watsonboyett/OttoRemix/firmware/OttoDIY_remix/src/README.md

# Libraries
This repository have all the main [Otto DIY robot](https://www.ottodiy.com/) libraries for Arduino compatible boards

## Installation:

1. [Download the .zip Otto libraries here](https://github.com/OttoDIY/OttoDIYLib/archive/master.zip)
2. Open Arduino IDE and navigate to Sketch > Include Library > Add .ZIP Library. At the top of the drop down list, select the option to ¨Add .ZIP Library¨.
3. You will be prompted to select the library. Navigate to the .zip file's location, that you just downloaded and open it.
4. In the main window you will see in the bottom back area a message that it has been installed. 
5. To verify they are properly installed, go to Sketch > Include Library menu. You should now see the library at the bottom of the drop-down menu. That means is ready to use Otto example codes! you can find them in File > Examples > OttoDIYLib
[for more details or other way to install libraries visit this link](https://www.arduino.cc/en/Guide/Libraries) 
 
## Compatibility:

We are making the libraries more modular and simple than ever, so that you can expand your robot functionallities as you go or you can change components based on your needs or the type of robot you want to make.
You can use both AVR boards like Arduino Nano or Arduino UNO and also ESP8266 or ESP32 boards by changing the definition of the pins.

All our bipedal robots are compatible with this libraries.

* Otto.h and Otto.cpp contains all the main functions
* Otto_gestures contains all the gestures functions
* Otto_mouths contains all the mouth functions
* Otto_sounds contains all the sound functions
* Otto_matrix contains all the matrix functions
* US contains the functions of the ultrasonic sesnor
* SerialCommand is for Bluetooth communication vis Software serial
* Oscillator is the main algorithm for the servos ¨smooth¨ movement
 
## Wiring:
These are the default connections fir AVR Arduino boards, but some Otto remixes do not use all pins or interchange them according to their needs, you can do that too, play with the pins and add new sensors, more motors, displays, LEDs and so on.

Servos| Pin
------------- | -------------
Left Leg or Left Wheel |  2 
Right  Leg or Right Wheel |  3
Left Foot | 4 
Right Foot |  5 
Left arm for Humanoid  |  6 
Right arm for Humanoid |  7 

Ultrasonic | Pin
------------- | -------------
Trigger | 8 
Echo | 9  

Bluetooth | Pin
------------- | -------------
STATE |  10  not required
TX | 11
RX | 12  
ENABLE |  not required

Buzzer | Pin
------------- | -------------
Positive | 13 
 
Touch sensor or Button | Pin
------------- | -------------
OUT | A0 

LED MATRIX 8x8 for the Mouth (MAX7219) | Pin
------------- | -------------
CLK Clock | A1 
CS Chip Select | A2  
DIN Data In | A3 

LED MATRIX 16x8 for the Eyes (i2C*)| Pin
------------- | -------------
SDA Synchronous Data | A4   
SCL Synchronous Clock | A5   

*More i2C devices like OLED or Gyro can be added in parallel by using different address

Sound sesnor | Pin
------------- | -------------
OUT | A6 

 ## How to Contribute:
Contributing to this software is warmly welcomed. There are 3 ways you can contribute to this project:
1. Test and if find a problem then post an issue.
2. Helps us solve the issues or other bugs.
3. Improve and optimize the curren libraries.
You can do this [basically by forking](https://help.github.com/en/articles/fork-a-repo), committing modifications and then [pulling requests](https://help.github.com/en/articles/about-pull-requests). 

Please add a change log and your contact into file header.

Big thanks to all our contributors 
- @JavierIH
- @Obijuan
- @jarsoftelectrical
- @stembotvn
- @sfranzyshen
- @tehniq3
- @logix5
- @DiegoSSJ
- @loreman
- @justinotherguy
- @bhm93
- @wendtbw
- @agomezgar
- @BodoMinea
- @chico
- @PinkDev1
- @MXZZ
- @Pawka
- @per1234
- @FedericoBusero
- @hulkco
- @mishafarms
- @nisha-appanah
- @pabloevaristo
- @ProgrammerBruce
- @Nca78 

Welcome to the [Otto DIY community](http://builders.ottodiy.com/)
