watsonboyett/OttoRemix/hardware/otto.brd

## EAGLE design hardware/otto.brd (2022-01-03)

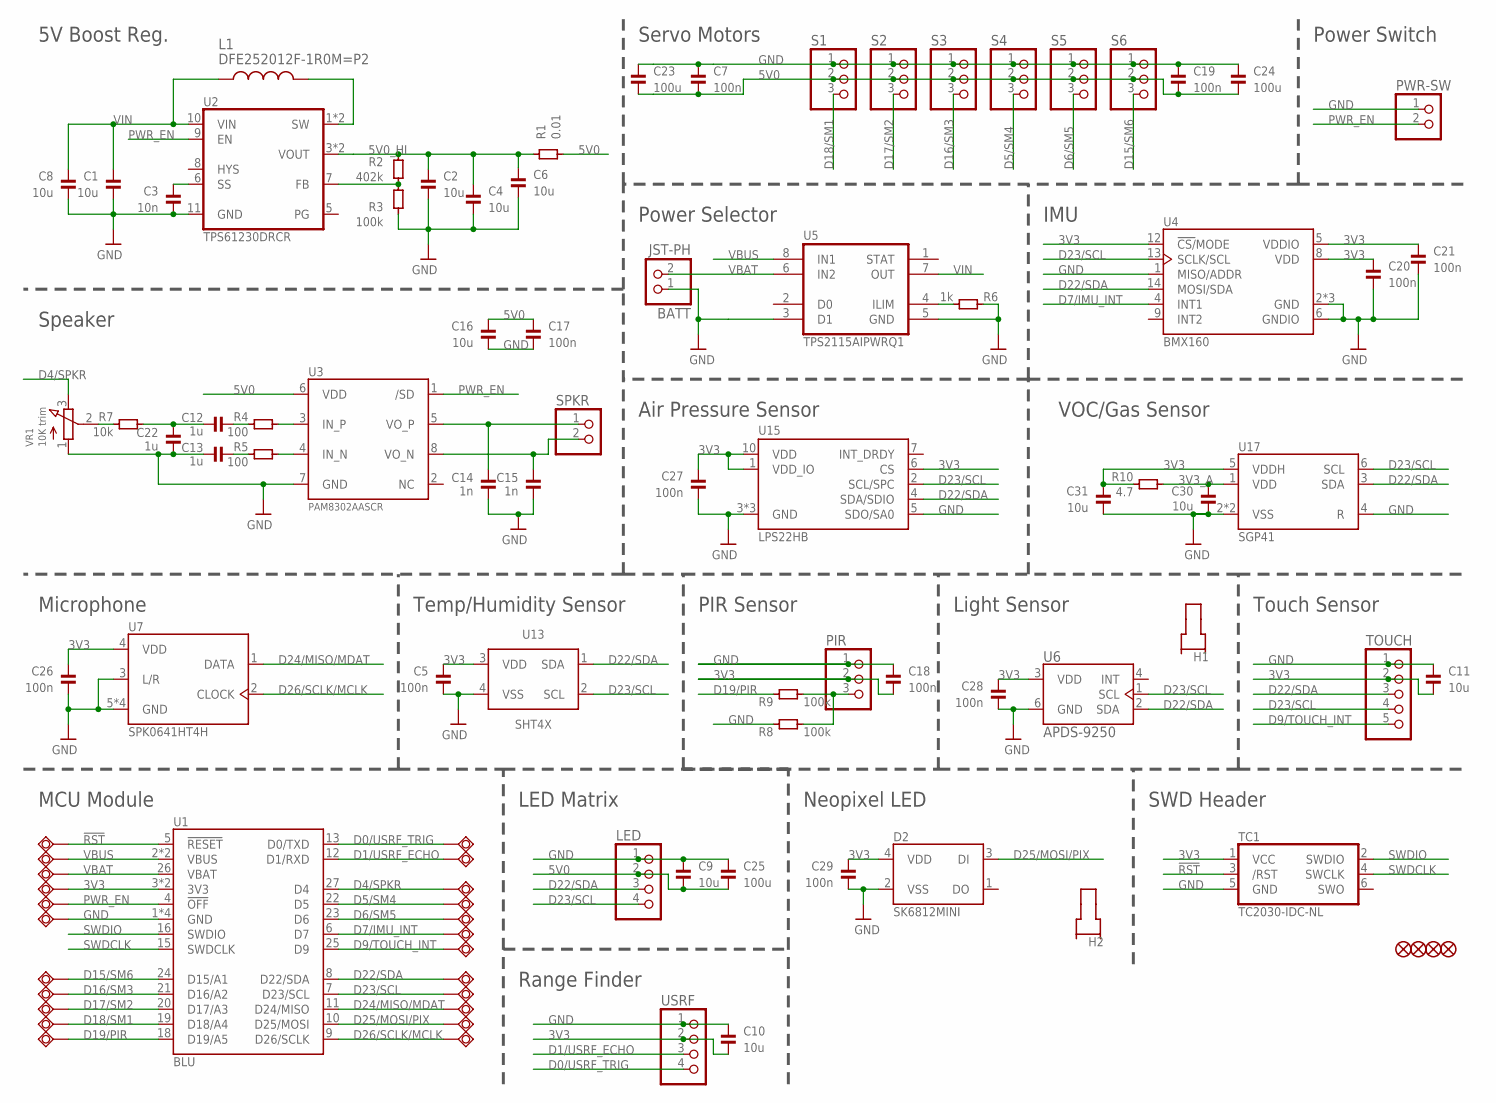
[picture p1: schematic otto.sch]

Parts:
3V3: TPSQTP10R; TP10R
BATT: JST-PH; JSTPH2-S2B
C1, C2, C4, C6, C8, C9, C10, C11, C16, C30, C31: 10u; _0603; MPN CL21A106KAYNNNE
C3: 10n; _0603; MPN CL21A106KAYNNNE
C5, C7, C17, C18, C19, C20, C21, C26, C27, C28, C29: 100n; _0603; MPN CL21A106KAYNNNE
C12, C13, C22: 1u; _0603; MPN CL21A106KAYNNNE
C14, C15: 1n; _0603; MPN CL21A106KAYNNNE
C23, C24, C25: 100u; _1206; MPN CL21A106KAYNNNE
D0, D1, D4, D5, D6, D7, D9, D15, D16, D17, D18, D19, D24, D25, D26: TPSQTP10R; TP10R
D2: SK6812MINI
FID1, FID2, FID3, FID5: FIDUCIAL0.8MM; FIDUCIAL_0.8MM
GND: TPSQTP10R; TP10R
H1, H2: VLP-XXX-X
L1: DFE252012F-1R0M=P2; INDC2520X120N
LED: PINHD-1X4; 1X04
PEN: TPSQTP10R; TP10R
PIR: PINHD-1X3; 1X03
PWR-SW: PINHD-1X2; 1X02
R1: 0.01; _0603
R2: 402k; _0603
R3, R8, R9: 100k; _0603
R4, R5: 100; _0603
R6: 1k; _0603
R7: 10k; _0603
R10: 4.7; _0603
RST: TPSQTP10R; TP10R
S1, S2, S3, S4, S5, S6: PINHD-1X3; 1X03
SCL: TPSQTP10R; TP10R
SDA: TPSQTP10R; TP10R
SPKR: PINHD-1X2; 1X02
TC1: TC2030-IDC-NL; TC2030-NL
TOUCH: PINHD-1X5; 1X05
U1: BLU
U2: TPS61230DRCR; VREG_V62/16624-01YE
U3: PAM8302AASCR; MSOP8_0.65MM
U4: BMX160; PQFN50P250X300X100-14N
U5: TPS2115AIPWRQ1; SOP65P640X120-8N
U6: APDS-9250; SON65P200X200X75-6N
U7: SPK0641HT4H; SPK0641HT4H-1
U13: SHT4X; SHT4X-DFN4
U15: LPS22HB; HLGA-10L
U17: SGP41
USRF: PINHD-1X4; 1X04
VBS: TPSQTP10R; TP10R
VBT: TPSQTP10R; TP10R
VR1: 10K trim; TRIMPOT_BOURNS_3303W

Connections:
3V3: 3V3.TP, C5.1, C10.2, C11.2, C18.2, C20.1, C21.1, C26.1, C27.1, C28.1, C29.1, C31.1, D2.4 (VDD), PIR.2, R10.1, TC1.1 (VCC), TOUCH.2, U1.3 (3V3), U1.28 (3V3), U4.5 (VDDIO), U4.8 (VDD), U4.12 (!CS/!MODE), U6.3 (VDD), U7.4 (VDD), U13.3 (VDD), U15.1 (VDD_IO), U15.6 (CS), U15.10 (VDD), U17.5 (VDDH), USRF.2
3V3_A: C30.1, R10.2, U17.1 (VDD)
5V0: C7.2, C9.2, C16.1, C17.1, C19.2, C23.2, C24.2, C25.2, LED.2, R1.1, S1.2, S2.2, S3.2, S4.2, S5.2, S6.2, U3.6 (VDD)
5V0_HI: C2.1, C4.1, C6.1, R1.2, R2.1, U2.3 (VOUT), U2.4 (VOUT)
!RST: RST.TP, TC1.3 (/RST), U1.5 (!RESET)
D0/USRF_TRIG: D0.TP, U1.13 (D0/TXD), USRF.4
D1/USRF_ECHO: D1.TP, U1.12 (D1/RXD), USRF.3
D4/SPKR: D4.TP, U1.27 (D4), VR1.3 (E)
D5/SM4: D5.TP, S4.3, U1.22 (D5)
D6/SM5: D6.TP, S5.3, U1.23 (D6)
D7/IMU_INT: D7.TP, U1.6 (D7), U4.4 (INT1)
D9/TOUCH_INT: D9.TP, TOUCH.5, U1.25 (D9)
D15/SM6: D15.TP, S6.3, U1.24 (D15/A1)
D16/SM3: D16.TP, S3.3, U1.21 (D16/A2)
D17/SM2: D17.TP, S2.3, U1.20 (D17/A3)
D18/SM1: D18.TP, S1.3, U1.19 (D18/A4)
D19/PIR: D19.TP, R9.1, U1.18 (D19/A5)
D22/SDA: LED.3, SDA.TP, TOUCH.3, U1.8 (D22/SDA), U4.14 (MOSI/SDA), U6.2 (SDA), U13.1 (SDA), U15.4 (SDA/SDIO), U17.3 (SDA)
D23/SCL: LED.4, SCL.TP, TOUCH.4, U1.7 (D23/SCL), U4.13 (SCLK/SCL), U6.1 (SCL), U13.2 (SCL), U15.2 (SCL/SPC), U17.6 (SCL)
D24/MISO/MDAT: D24.TP, U1.11 (D24/MISO), U7.1 (DATA)
D25/MOSI/PIX: D2.3 (DI), D25.TP, U1.10 (D25/MOSI)
D26/SCLK/MCLK: D26.TP, U1.9 (D26/SCLK), U7.2 (CLOCK)
GND: BATT.1, C1.2, C2.2, C3.2, C4.2, C5.2, C6.2, C7.1, C8.2, C9.1, C10.1, C11.1, C13.1, C14.1, C15.1, C16.2, C17.2, C18.1, C19.1, C20.2, C21.2, C22.1, C23.1, C24.1, C25.1, C26.2, C27.2, C28.2, C29.2, C30.2, C31.2, D2.2 (VSS), GND.TP, LED.1, PIR.1, PWR-SW.1, R3.2, R6.1, R8.1, S1.1, S2.1, S3.1, S4.1, S5.1, S6.1, TC1.5 (GND), TOUCH.1, U1.1 (GND), U1.14 (GND), U1.17 (GND), U1.30 (GND), U2.11 (GND), U3.7 (GND), U4.1 (MISO/ADDR), U4.2 (GND), U4.3 (GND), U4.6 (GNDIO), U4.7 (GND), U5.3 (D1), U5.5 (GND), U6.6 (GND), U7.3 (L/R), U7.5 (GND), U7.6 (GND), U7.7 (GND), U7.8 (GND), U13.4 (VSS), U15.3 (GND), U15.5 (SDO/SA0), U15.8 (GND), U15.9 (GND), U17.2 (VSS), U17.4 (R), U17.EP (VSS), USRF.1, VR1.1 (A)
unnamed: C3.1, U2.6 (SS)
unnamed: R2.2, R3.1, U2.7 (FB)
unnamed: R7.1, VR1.2 (S)
unnamed: C12.1, C22.2, R7.2
unnamed: PIR.3, R8.2, R9.2
unnamed: R6.2, U5.4 (ILIM)
unnamed: L1.2, U2.1 (SW), U2.2 (SW)
unnamed: C12.2, R4.1
unnamed: C13.2, R5.1
unnamed: R4.2, U3.3 (IN_P)
unnamed: R5.2, U3.4 (IN_N)
unnamed: C14.2, SPKR.1, U3.5 (VO_P)
unnamed: C15.2, SPKR.2, U3.8 (VO_N)
PWR_EN: PEN.TP, PWR-SW.2, U1.4 (!OFF), U2.9 (EN), U3.1 (/SD)
SWDCLK: TC1.4 (SWCLK), U1.15 (SWDCLK)
SWDIO: TC1.2 (SWDIO), U1.16 (SWDIO)
VBAT: BATT.2, U1.26 (VBAT), U5.6 (IN2), VBT.TP
VBUS: U1.2 (VBUS), U1.29 (VBUS), U5.8 (IN1), VBS.TP
VIN: C1.1, C8.1, L1.1, U2.10 (VIN), U5.7 (OUT)

Notes on the sheet:
MCU Module
5V Boost Reg.
SWD Header
Servo Motors
Power Switch
Touch Sensor
Range Finder
LED Matrix
Speaker
Microphone
IMU
Power Selector
Temp/Humidity Sensor
PIR Sensor
Light Sensor
Air Pressure Sensor
Neopixel LED
VOC/Gas Sensor

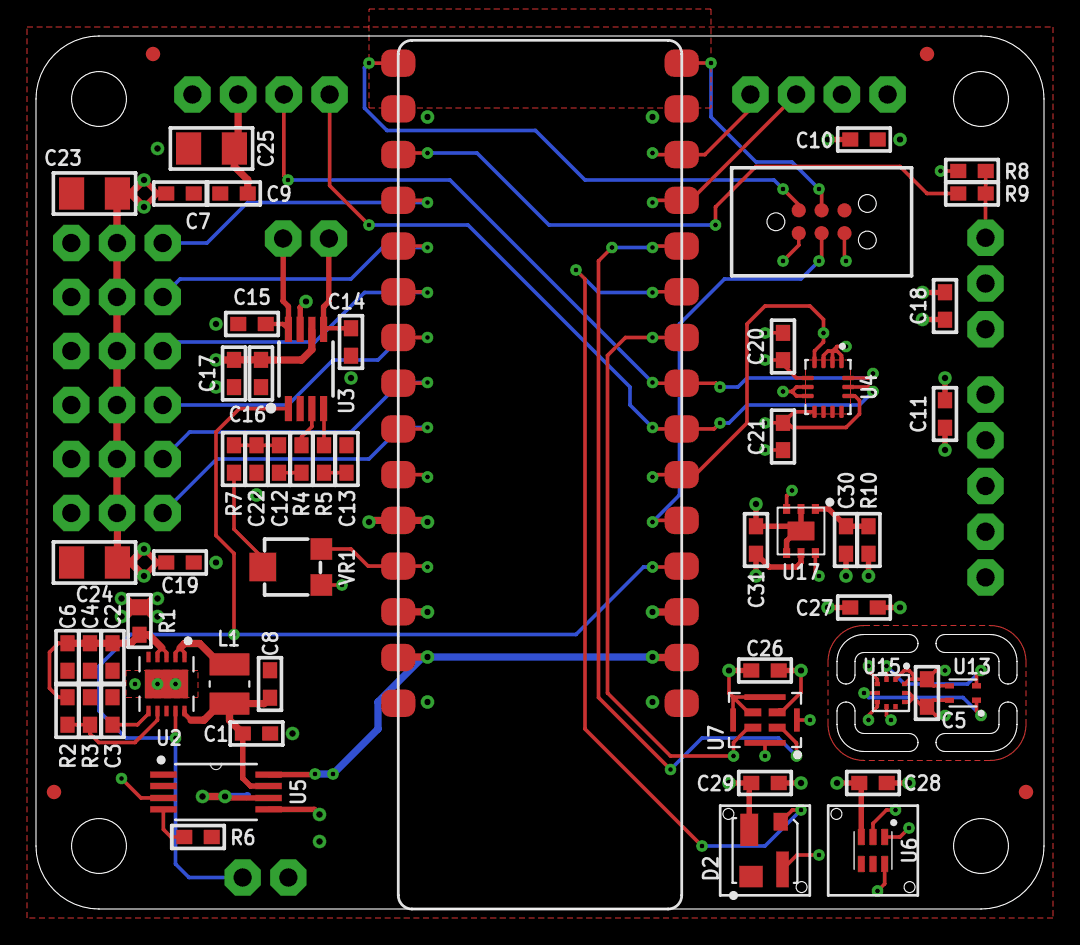
[picture p2: board otto.brd from above]

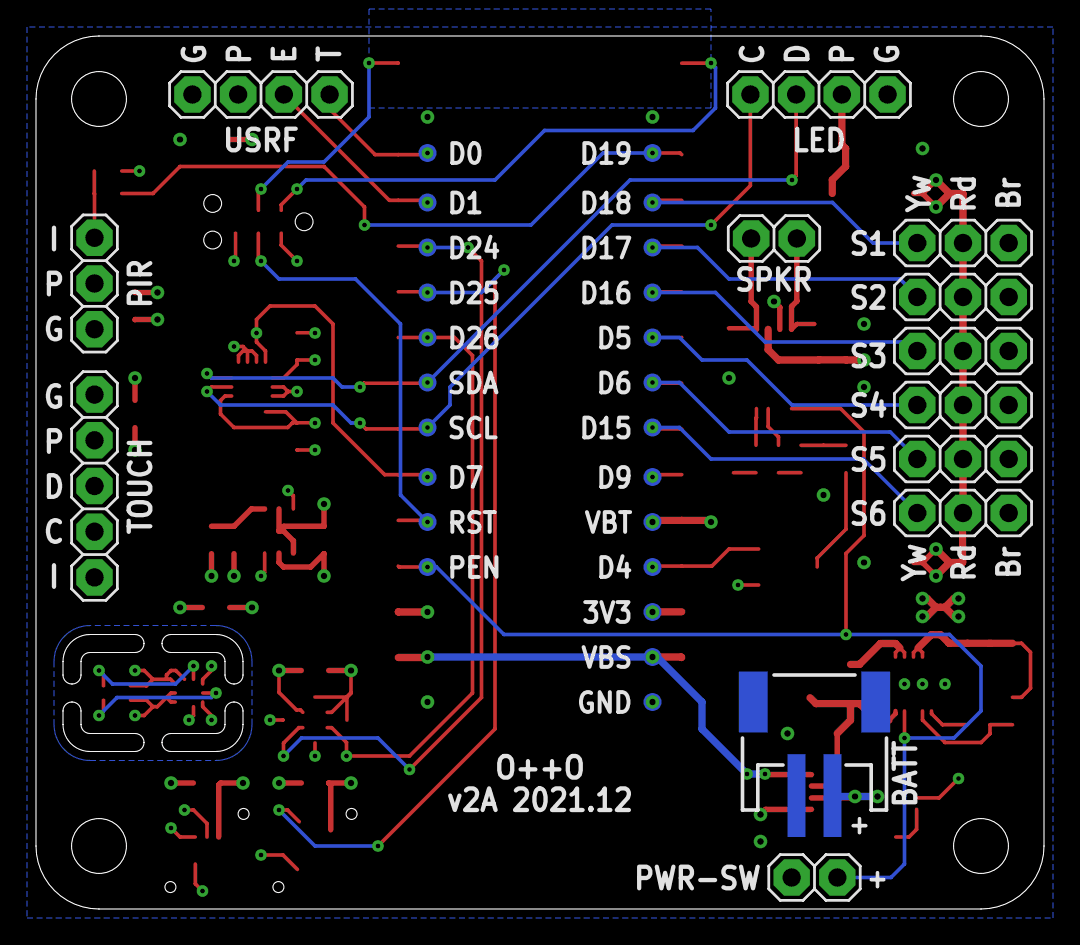
[picture p3: board otto.brd from below]

Board: 4 copper layers, 56.0 x 48.5 mm, 101 parts (36 on the bottom side), 42 nets.

Other parts of the board:
U$5, U$6, U$7, U$8: HOLE_4-40_NORM_BUTTON
