watsonboyett/OttoRemix/firmware/OttoDIY_remix/src/Otto_gestures.h

#ifndef Otto_gestures_h
#define Otto_gestures_h

//***********************************************************************************
//*********************************GESTURE DEFINES***********************************
//***********************************************************************************           

#define OttoHappy 		0
#define OttoSuperHappy 	1
#define OttoSad 		2
#define OttoSleeping 	3
#define OttoFart 		4
#define OttoConfused 	5
#define OttoLove 		6
#define OttoAngry 		7
#define OttoFretful 	8
#define OttoMagic 		9
#define OttoWave 		10
#define OttoVictory 	11
#define OttoFail 		12

//*** MOUTH ANIMATIONS***
#define littleUuh		0
#define dreamMouth		1 	
#define adivinawi		2
#define wave 			3


typedef struct 
{
  uint8_t Character[1];
  uint8_t data[6];
}
LED_Matrix_Font_6x8_TypeDef;

//Terminal
const LED_Matrix_Font_6x8_TypeDef Character_font_6x8[] PROGMEM =
{

    '0',  0x00,0x7C,0x82,0x82,0x7C,0x00,
    '1',  0x00,0x42,0xFE,0x02,0x00,0x00,
    '2',  0x00,0x46,0x8A,0x92,0x62,0x00,
    '3',  0x00,0x44,0x92,0x92,0x6C,0x00,
    '4',  0x00,0x1C,0x64,0xFE,0x04,0x00,
    '5',  0x00,0xF2,0x92,0x92,0x8C,0x00,
    '6',  0x00,0x7C,0x92,0x92,0x4C,0x00,
    '7',  0x00,0xC0,0x8E,0x90,0xE0,0x00,
    '8',  0x00,0x6C,0x92,0x92,0x6C,0x00,
    '9',  0x00,0x64,0x92,0x92,0x7C,0x00,
    ':',  0x00,0x00,0x14,0x00,0x00,0x00,
    ';',  0x00,0x02,0x24,0x00,0x00,0x00,
    '<',  0x00,0x10,0x28,0x44,0x82,0x00, 
    '=',  0x00,0x28,0x28,0x28,0x28,0x00,
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

template <typename T> void PROGMEM_readAnything (const T * sce, T& dest)
  {
  memcpy_P (&dest, sce, sizeof (T));
  }

template <typename T> T PROGMEM_getAnything (const T * sce)
  {
  static T temp;
  memcpy_P (&temp, sce, sizeof (T));
  return temp;
  }

#endif
