watsonboyett/OttoRemix/firmware/bringup_pio/src/LedBitmaps.h

#pragma once

#include <Arduino.h>

static const uint8_t PROGMEM
    smile_bmp[] =
        {
            B00000000,
            B00000000,
            B00000000,
            B00000011,
            B00000110,
            B00001100,
            B00011000,
            B00011000, //
            B00011000, //
            B00011000,
            B00001100,
            B00000110,
            B00000011,
            B00000000,
            B00000000,
            B00000000},
    neutral_bmp[] =
        {
            B00000000,
            B00000000,
            B00000000,
            B00011000,
            B00011000,
            B00011000,
            B00011000,
            B00011000, //
            B00011000, //
            B00011000,
            B00011000,
            B00011000,
            B00011000,
            B00000000,
            B00000000,
            B00000000},
    frown_bmp[] =
        {
            B00000000,
            B00000000,
            B00000000,
            B11000000,
            B01100000,
            B00110000,
            B00011000,
            B00011000, //
            B00011000, //
            B00011000,
            B00110000,
            B01100000,
            B11000000,
            B00000000,
            B00000000,
            B00000000},
    mute_bmp[] =
        {
            B00000000,
            B00000000,
            B00000000,
            B11000011,
            B01100110,
            B00111100,
            B00011000,
            B00011000, //
            B00011000, //
            B00011000,
            B00111100,
            B01100110,
            B11000011,
            B00000000,
            B00000000,
            B00000000};
