watsonboyett/OttoRemix/(commit log)

2020-11-09 Initial hardware design
    [otto.brd, otto.sch]
2020-11-15 Implemented tasks using soft timer
2021-11-24 BLE app kinda works now, but only with the servos
2021-12-22 Hardware changes for v1B, see readme file
    [otto.brd, otto.sch]
2021-12-22 Testing for IMU calibration, SD/FAT file support, BLE support
2022-01-03 Lots of PCB changes v2 (see hardware readme)
    [otto.brd, otto.sch]
