watsonboyett/OttoRemix/(notices)

Notices in the files:
hardware/otto.sch:
LICENSE: CC-BY-SA
